Arachnid/dfpga/discretefpga.brd

## EAGLE design discretefpga.brd (2012-10-31)

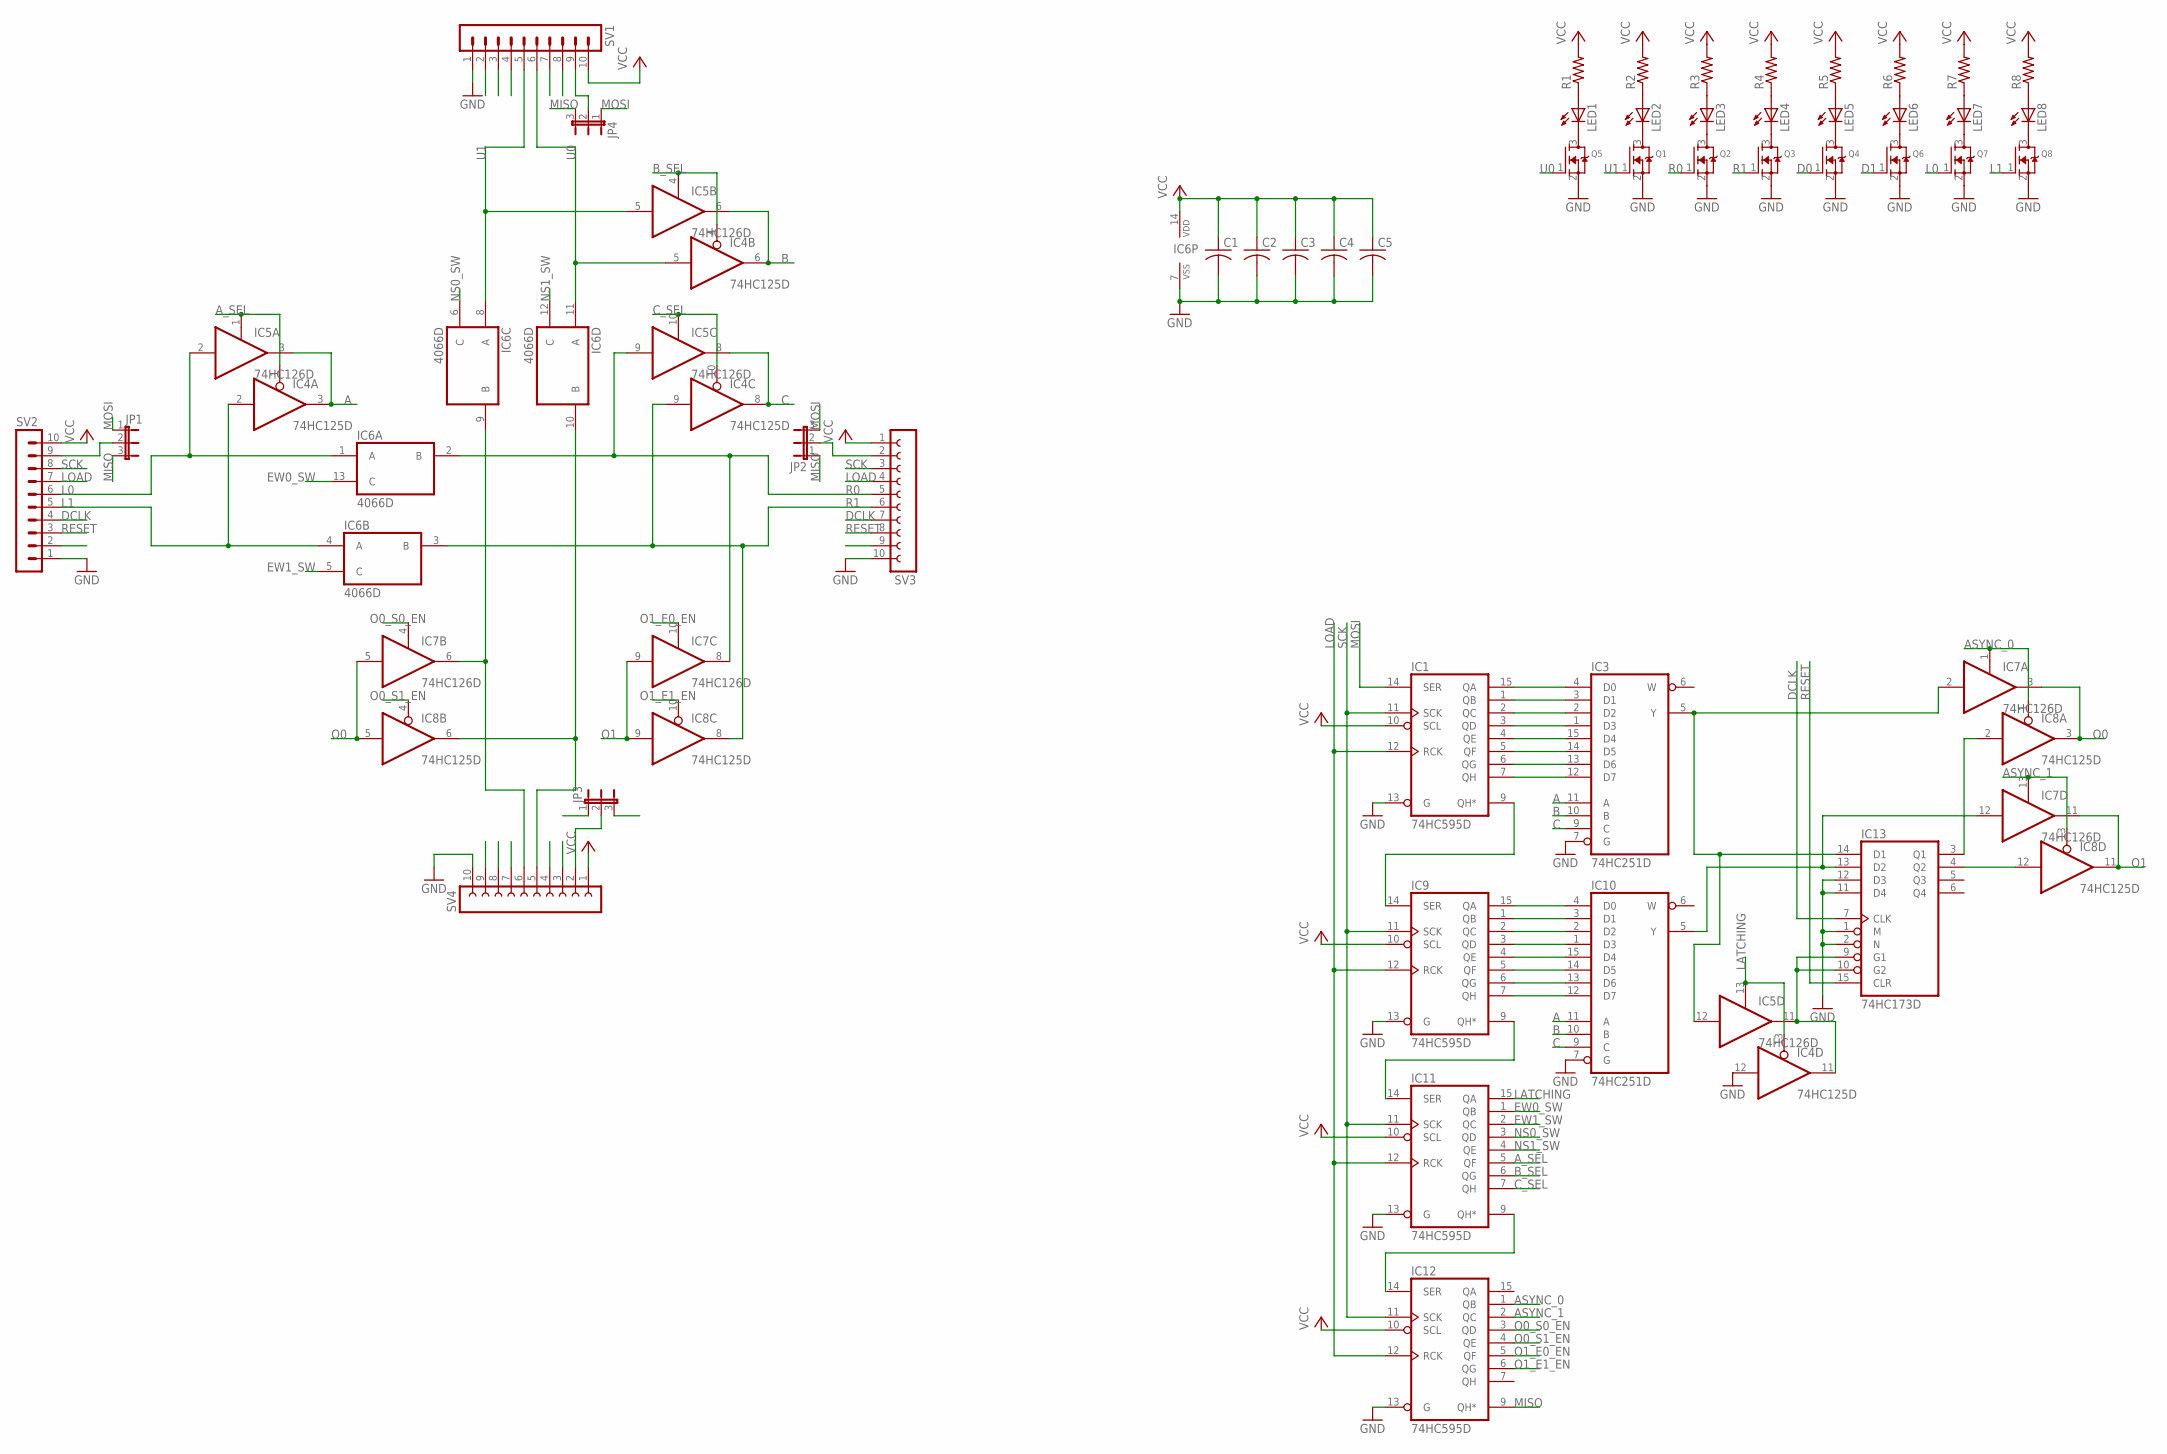
[picture p1: schematic discretefpga.sch]

Parts:
C1, C2, C3, C4, C5: C-USC0805; C0805
IC1, IC9, IC11, IC12: 74HC595D; SO16
IC3, IC10: 74HC251D; SO16
IC4, IC8: 74HC125D; SO14
IC5, IC7: 74HC126D; SO14
IC6: 4066D; SO14
IC13: 74HC173D; SO16
JP1, JP2, JP3, JP4: JP2E; JP2
LED1, LED2, LED3, LED4, LED5, LED6, LED7, LED8: LEDCHIP-LED0805; CHIP-LED0805
Q1, Q2, Q3, Q4, Q5, Q6, Q7, Q8: MOSFET-NREFLOW; SOT23
R1, R2, R3, R4, R5, R6, R7, R8: R-US_R0805; R0805
SV1, SV2: MA10-1W
SV3, SV4: FE10W

Connections:
A: IC3.11 (A), IC4.3 (O), IC5.3 (O), IC10.11 (A)
ASYNC_0: IC7.1 (OE), IC8.1 (OE), IC12.1 (QB)
ASYNC_1: IC7.13 (OE), IC8.13 (OE), IC12.2 (QC)
A_SEL: IC4.1 (OE), IC5.1 (OE), IC11.5 (QF)
B: IC3.10 (B), IC4.6 (O), IC5.6 (O), IC10.10 (B)
B_SEL: IC4.4 (OE), IC5.4 (OE), IC11.6 (QG)
C: IC3.9 (C), IC4.8 (O), IC5.8 (O), IC10.9 (C)
C_SEL: IC4.10 (OE), IC5.10 (OE), IC11.7 (QH)
D0: IC6.10 (B), IC8.6 (O), Q4.1 (G), SV4.5
D1: IC6.9 (B), IC7.6 (O), Q6.1 (G), SV4.6
DCLK: IC13.7 (CLK), SV1.4, SV2.4, SV3.7, SV4.7
EW0_SW: IC6.13 (C), IC11.1 (QB)
EW1_SW: IC6.5 (C), IC11.2 (QC)
GND: C1.2, C2.2, C3.2, C4.2, C5.2, IC1.8 (GND), IC1.13 (G), IC3.7 (G), IC3.8 (GND), IC4.7 (GND), IC4.12 (I), IC5.7 (GND), IC6.7 (VSS), IC7.7 (GND), IC8.7 (GND), IC9.8 (GND), IC9.13 (G), IC10.7 (G), IC10.8 (GND), IC11.8 (GND), IC11.13 (G), IC12.8 (GND), IC12.13 (G), IC13.1 (M), IC13.2 (N), IC13.8 (GND), IC13.11 (D4), IC13.12 (D3), Q1.2 (S), Q2.2 (S), Q3.2 (S), Q4.2 (S), Q5.2 (S), Q6.2 (S), Q7.2 (S), Q8.2 (S), SV1.1, SV2.1, SV3.10, SV4.10
L0: IC5.2 (I), IC6.1 (A), Q7.1 (G), SV2.6
L1: IC4.2 (I), IC6.4 (A), Q8.1 (G), SV2.5
LATCHING: IC4.13 (OE), IC5.13 (OE), IC11.15 (QA)
LOAD: IC1.12 (RCK), IC9.12 (RCK), IC11.12 (RCK), IC12.12 (RCK), SV1.7, SV2.7, SV3.4, SV4.4
MISO: IC12.9 (QH*), JP1.3, JP2.1, JP3.1, JP4.3
MOSI: IC1.14 (SER), JP1.1, JP2.3, JP3.3, JP4.1
unnamed: IC1.15 (QA), IC3.4 (D0)
unnamed: IC1.1 (QB), IC3.3 (D1)
unnamed: IC1.2 (QC), IC3.2 (D2)
unnamed: IC1.4 (QE), IC3.15 (D4)
unnamed: IC1.5 (QF), IC3.14 (D5)
unnamed: IC1.6 (QG), IC3.13 (D6)
unnamed: IC1.7 (QH), IC3.12 (D7)
unnamed: IC3.5 (Y), IC5.12 (I), IC7.2 (I), IC13.14 (D1)
unnamed: IC9.15 (QA), IC10.4 (D0)
unnamed: IC4.11 (O), IC5.11 (O), IC13.9 (G1), IC13.10 (G2)
unnamed: IC9.1 (QB), IC10.3 (D1)
unnamed: IC9.2 (QC), IC10.2 (D2)
unnamed: IC9.4 (QE), IC10.15 (D4)
unnamed: IC9.5 (QF), IC10.14 (D5)
unnamed: IC9.6 (QG), IC10.13 (D6)
unnamed: IC9.7 (QH), IC10.12 (D7)
unnamed: IC7.12 (I), IC10.5 (Y), IC13.13 (D2)
unnamed: IC1.9 (QH*), IC9.14 (SER)
unnamed: IC8.2 (I), IC13.3 (Q1)
unnamed: IC9.9 (QH*), IC11.14 (SER)
unnamed: IC11.9 (QH*), IC12.14 (SER)
unnamed: JP1.2, SV2.9
unnamed: JP2.2, SV3.2
unnamed: LED1.A, R1.1
unnamed: LED1.C, Q5.3 (D)
unnamed: IC8.12 (I), IC13.4 (Q2)
unnamed: IC9.3 (QD), IC10.1 (D3)
unnamed: IC1.3 (QD), IC3.1 (D3)
unnamed: LED2.C, Q1.3 (D)
unnamed: LED2.A, R2.1
unnamed: LED3.A, R3.1
unnamed: LED4.A, R4.1
unnamed: LED5.A, R5.1
unnamed: LED6.A, R6.1
unnamed: LED7.A, R7.1
unnamed: LED8.A, R8.1
unnamed: LED3.C, Q2.3 (D)
unnamed: LED4.C, Q3.3 (D)
unnamed: LED5.C, Q4.3 (D)
unnamed: JP3.2, SV4.2
unnamed: LED6.C, Q6.3 (D)
unnamed: JP4.2, SV1.9
unnamed: LED7.C, Q7.3 (D)
unnamed: LED8.C, Q8.3 (D)
NS0_SW: IC6.6 (C), IC11.3 (QD)
NS1_SW: IC6.12 (C), IC11.4 (QE)
O0: IC7.3 (O), IC7.5 (I), IC8.3 (O), IC8.5 (I)
O0_S0_EN: IC7.4 (OE), IC12.3 (QD)
O0_S1_EN: IC8.4 (OE), IC12.4 (QE)
O1: IC7.9 (I), IC7.11 (O), IC8.9 (I), IC8.11 (O)
O1_E0_EN: IC7.10 (OE), IC12.5 (QF)
O1_E1_EN: IC8.10 (OE), IC12.6 (QG)
R0: IC5.9 (I), IC6.2 (B), IC7.8 (O), Q2.1 (G), SV3.5
R1: IC4.9 (I), IC6.3 (B), IC8.8 (O), Q3.1 (G), SV3.6
RESET: IC13.15 (CLR), SV1.3, SV2.3, SV3.8, SV4.8
SCK: IC1.11 (SCK), IC9.11 (SCK), IC11.11 (SCK), IC12.11 (SCK), SV1.8, SV2.8, SV3.3, SV4.3
U0: IC4.5 (I), IC6.11 (A), Q5.1 (G), SV1.6
U1: IC5.5 (I), IC6.8 (A), Q1.1 (G), SV1.5
VCC: C1.1, C2.1, C3.1, C4.1, C5.1, IC1.10 (SCL), IC1.16 (VCC), IC3.16 (VCC), IC4.14 (VCC), IC5.14 (VCC), IC6.14 (VDD), IC7.14 (VCC), IC8.14 (VCC), IC9.10 (SCL), IC9.16 (VCC), IC10.16 (VCC), IC11.10 (SCL), IC11.16 (VCC), IC12.10 (SCL), IC12.16 (VCC), IC13.16 (VCC), R1.2, R2.2, R3.2, R4.2, R5.2, R6.2, R7.2, R8.2, SV1.10, SV2.10, SV3.1, SV4.1

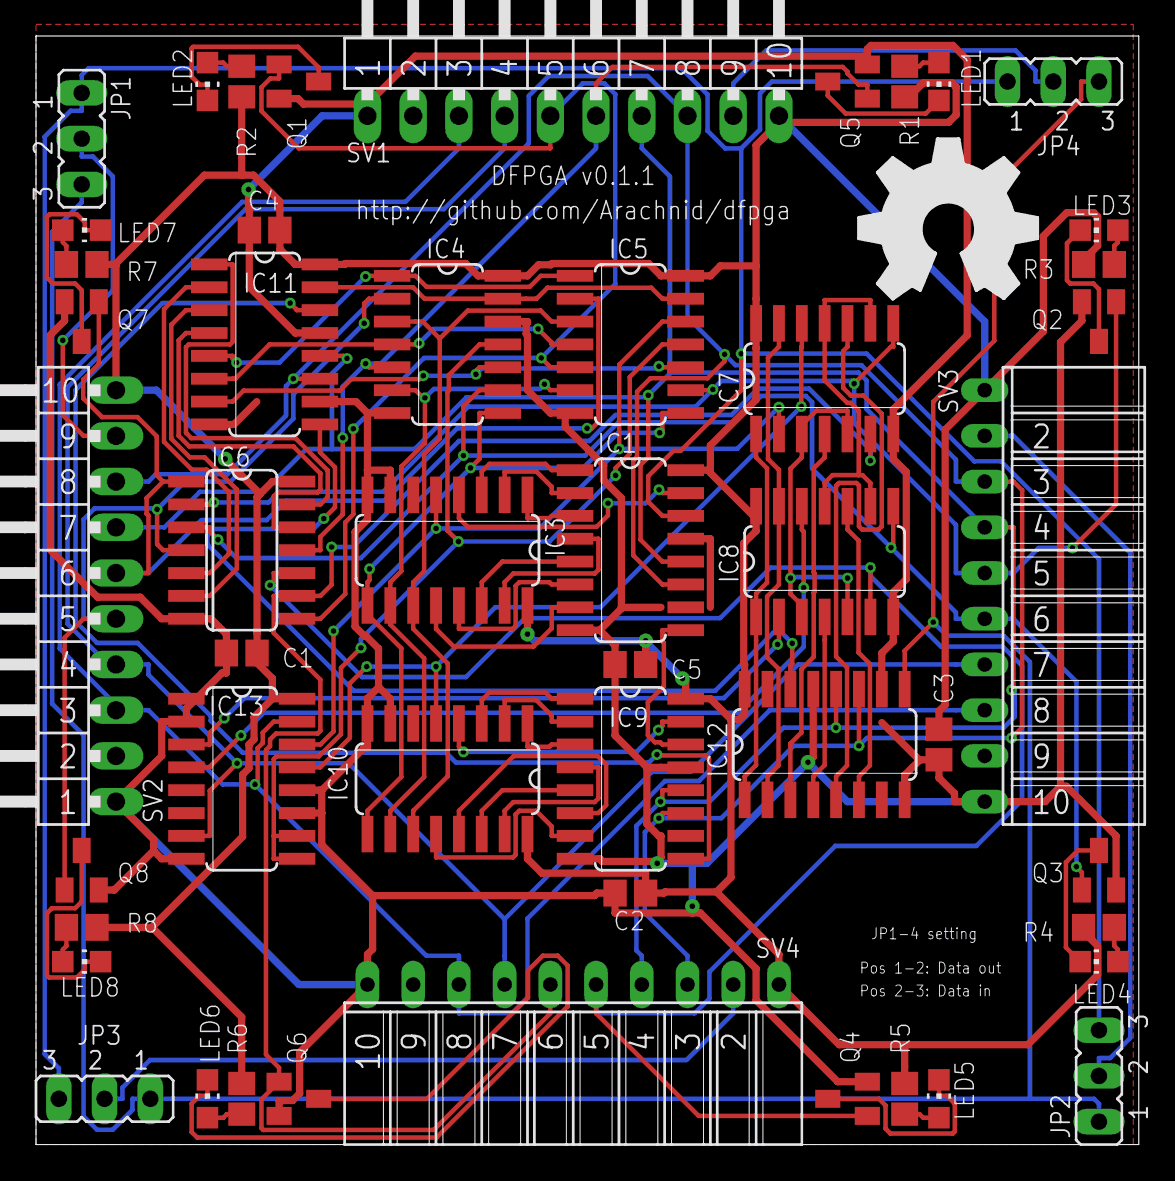
[picture p2: board discretefpga.brd from above]

Board: 2 copper layers, 61.3 x 61.6 mm, 50 parts (0 on the bottom side), 79 nets.

Other parts of the board:
U$1: OSHW_FILLX350_NOTEXT
