Arachnid/dfpga/(threads)

Thread 1 (2014-01-03):

Question about schematic.

mainiak, 2014-01-03:
Hi.

Sorry for dummy question, but what is circuit IC6P in schematics good for?
That's the little board beside (bigger) slice board in your photo?
And what are values for C1-C6?

What is Q1-Q8? And what are R1-R8 values?

I tried to find answer inside schematic or in article but without luck.
http://blog.notdot.net/2012/10/Build-your-own-FPGA

What am I overlooking?

Thank you in advance.

penserbjorne, 2016-12-04:
Hi @mainiak .

Q1-Q8 I think are transistors, just for the led's.
R1-R8 depend from the led's value.
C1-C6 are just capacitor to reduce the noise (I guess), you can use (maybe) with 0.1 microF.

Regards!!! :D

Arachnid, 2016-12-04:
I actually don't have Eagle installed anymore - I moved to DipTrace - so I'm going to have to go off memory here.

IC6P is, I think, the power pins for IC6. Although they're all shown as separate components, they're actually parts of the same IC.

@penserbjorne is right about the components; R1-R8 should be selected such that they limit the LED current to ~5mA, and C1-C6 can be 0.1uF ceramics.

mainiak, 2016-12-05:
Thank you @penserbjorne and @Arachnid for answering my 3 years old question. You made my day :)

Closed 2016-12-05.

Thread 2 (2016-12-05):

What does arduino? :(

penserbjorne, 2016-12-05:
Hi Nick.

First of all, thanks for this great project :)

I have a doubt, on the [video](https://www.youtube.com/watch?v=7r0CuxFMGBQ) I see you use an Arduino to load the program, how do you do it? Can you share the program/diagram (If you still have it)? Or at least explain it? :)

And I don't have very clear how to use the switches :/ so, if you can say something about it would be great!

Thanks!

Arachnid, 2016-12-05:
I don't still have the program, but it's pretty simple - just stick the data you want to shift into the modules in a variable and use `shiftOut` to send it.

What switches are you referring to?

penserbjorne, 2016-12-05:
Ok, let me read about shiftOut :)

I mean the external switches conected, I dont know if are just to program (send data to registers) or as inputs or both.

And the jumpers, the same as the switches, are just to select if the lines are input/output and/or for expasion?

Arachnid, 2016-12-05:
It's been a long time, but IIRC, the switches and jumpers let you select the input and output routing for the programming data signals, so that you can chain them in the right directions and program them all at once.

penserbjorne, 2016-12-05:
Ok, I'll be working on that.

Thanks!

Closed 2016-12-05.
